nrivard/Sixty-n8k/Sixty-n8k/Sixty-n8k.pdf

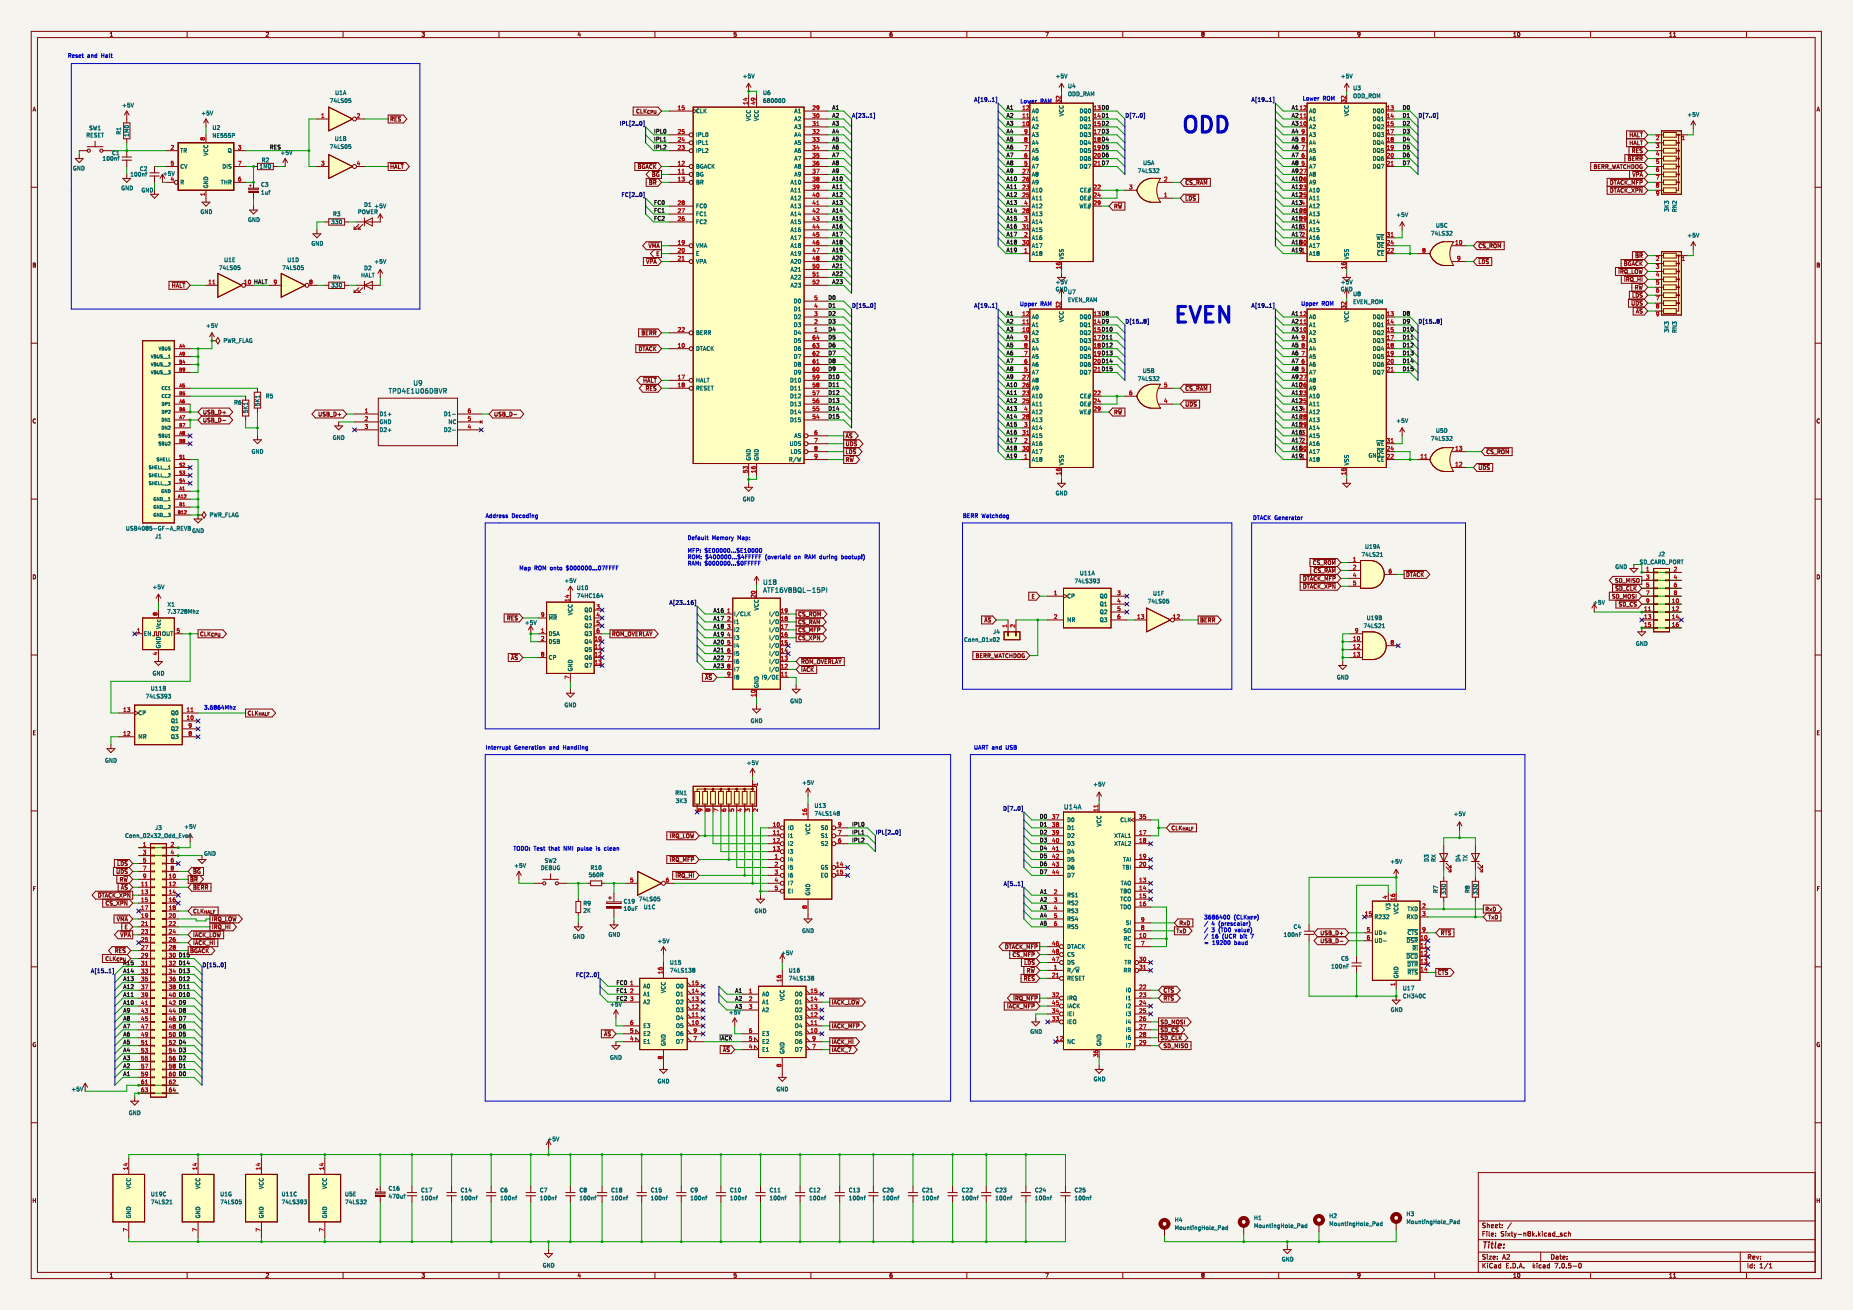
[picture p1: page 1]
