nrivard/Sixty-n8k/(list of files, drawings)

Other design files:
Sixty-n8k/freerouting.dsn
Sixty-n8k/Sixty-n8k.dsn
Sixty-n8k/temp-freerouting.dsn
