nrivard/Sixty-n8k/Sixty-n8k/Sixty-n8k.kicad_pcb

## KiCad design Sixty-n8k/Sixty-n8k.kicad_pcb (2024-03-06)

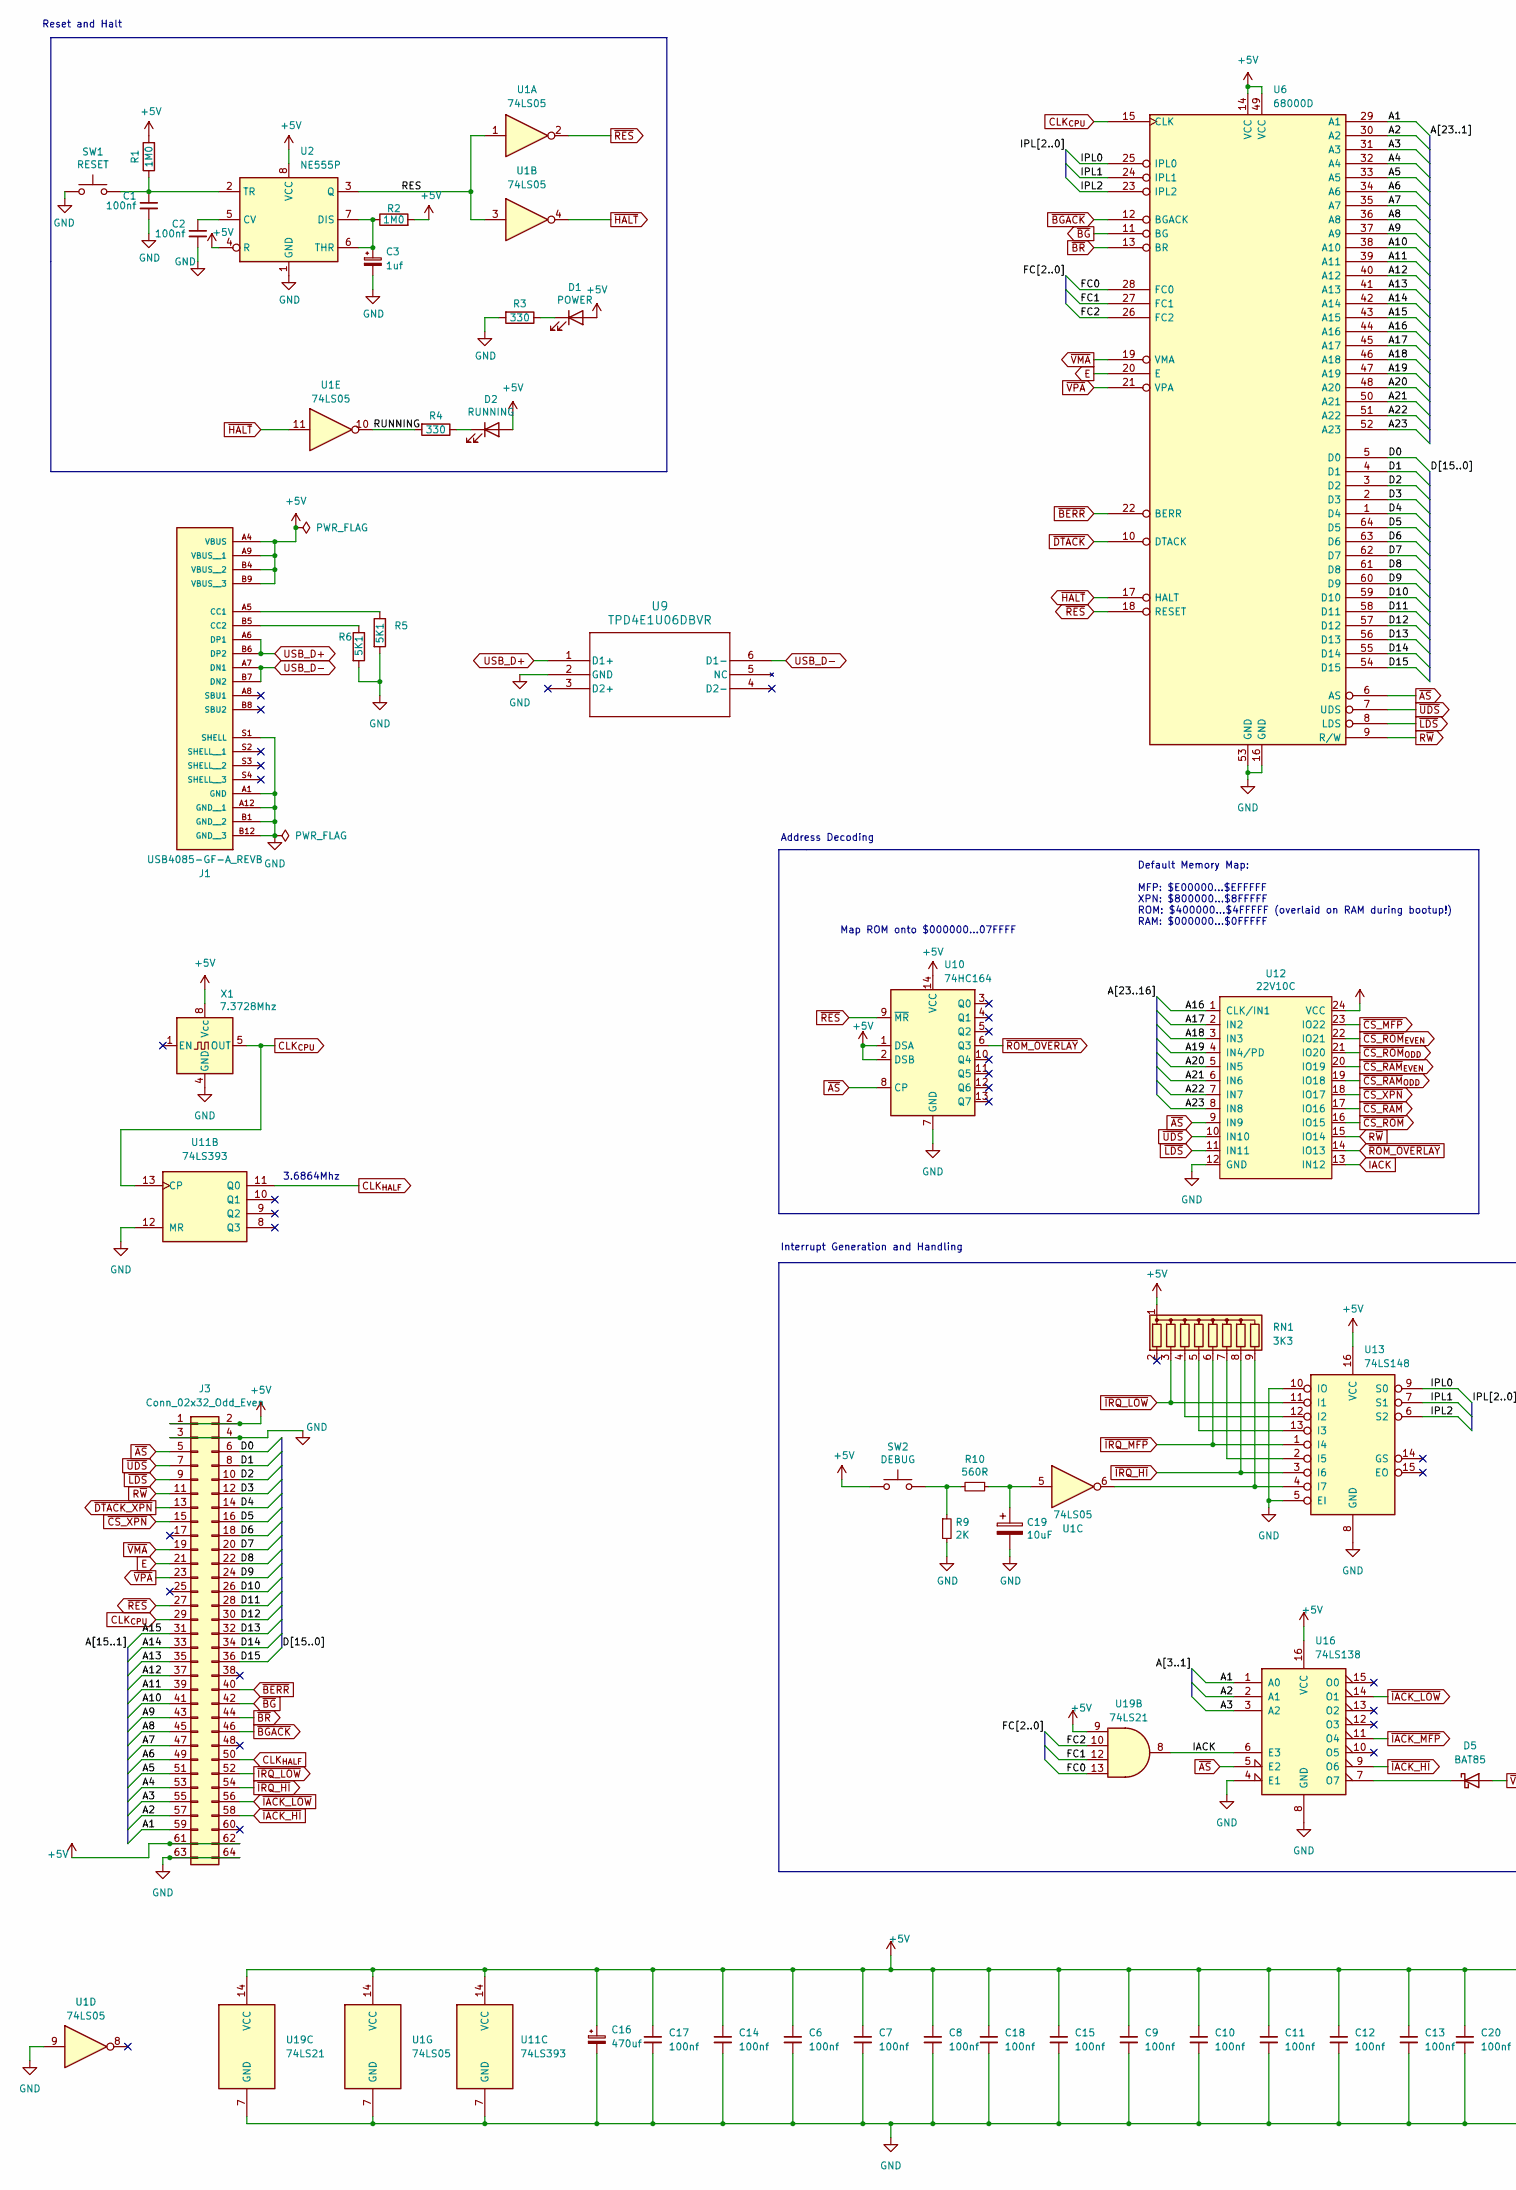
[picture p2: schematic Sixty-n8k.kicad_sch, part in row 1, column 1]

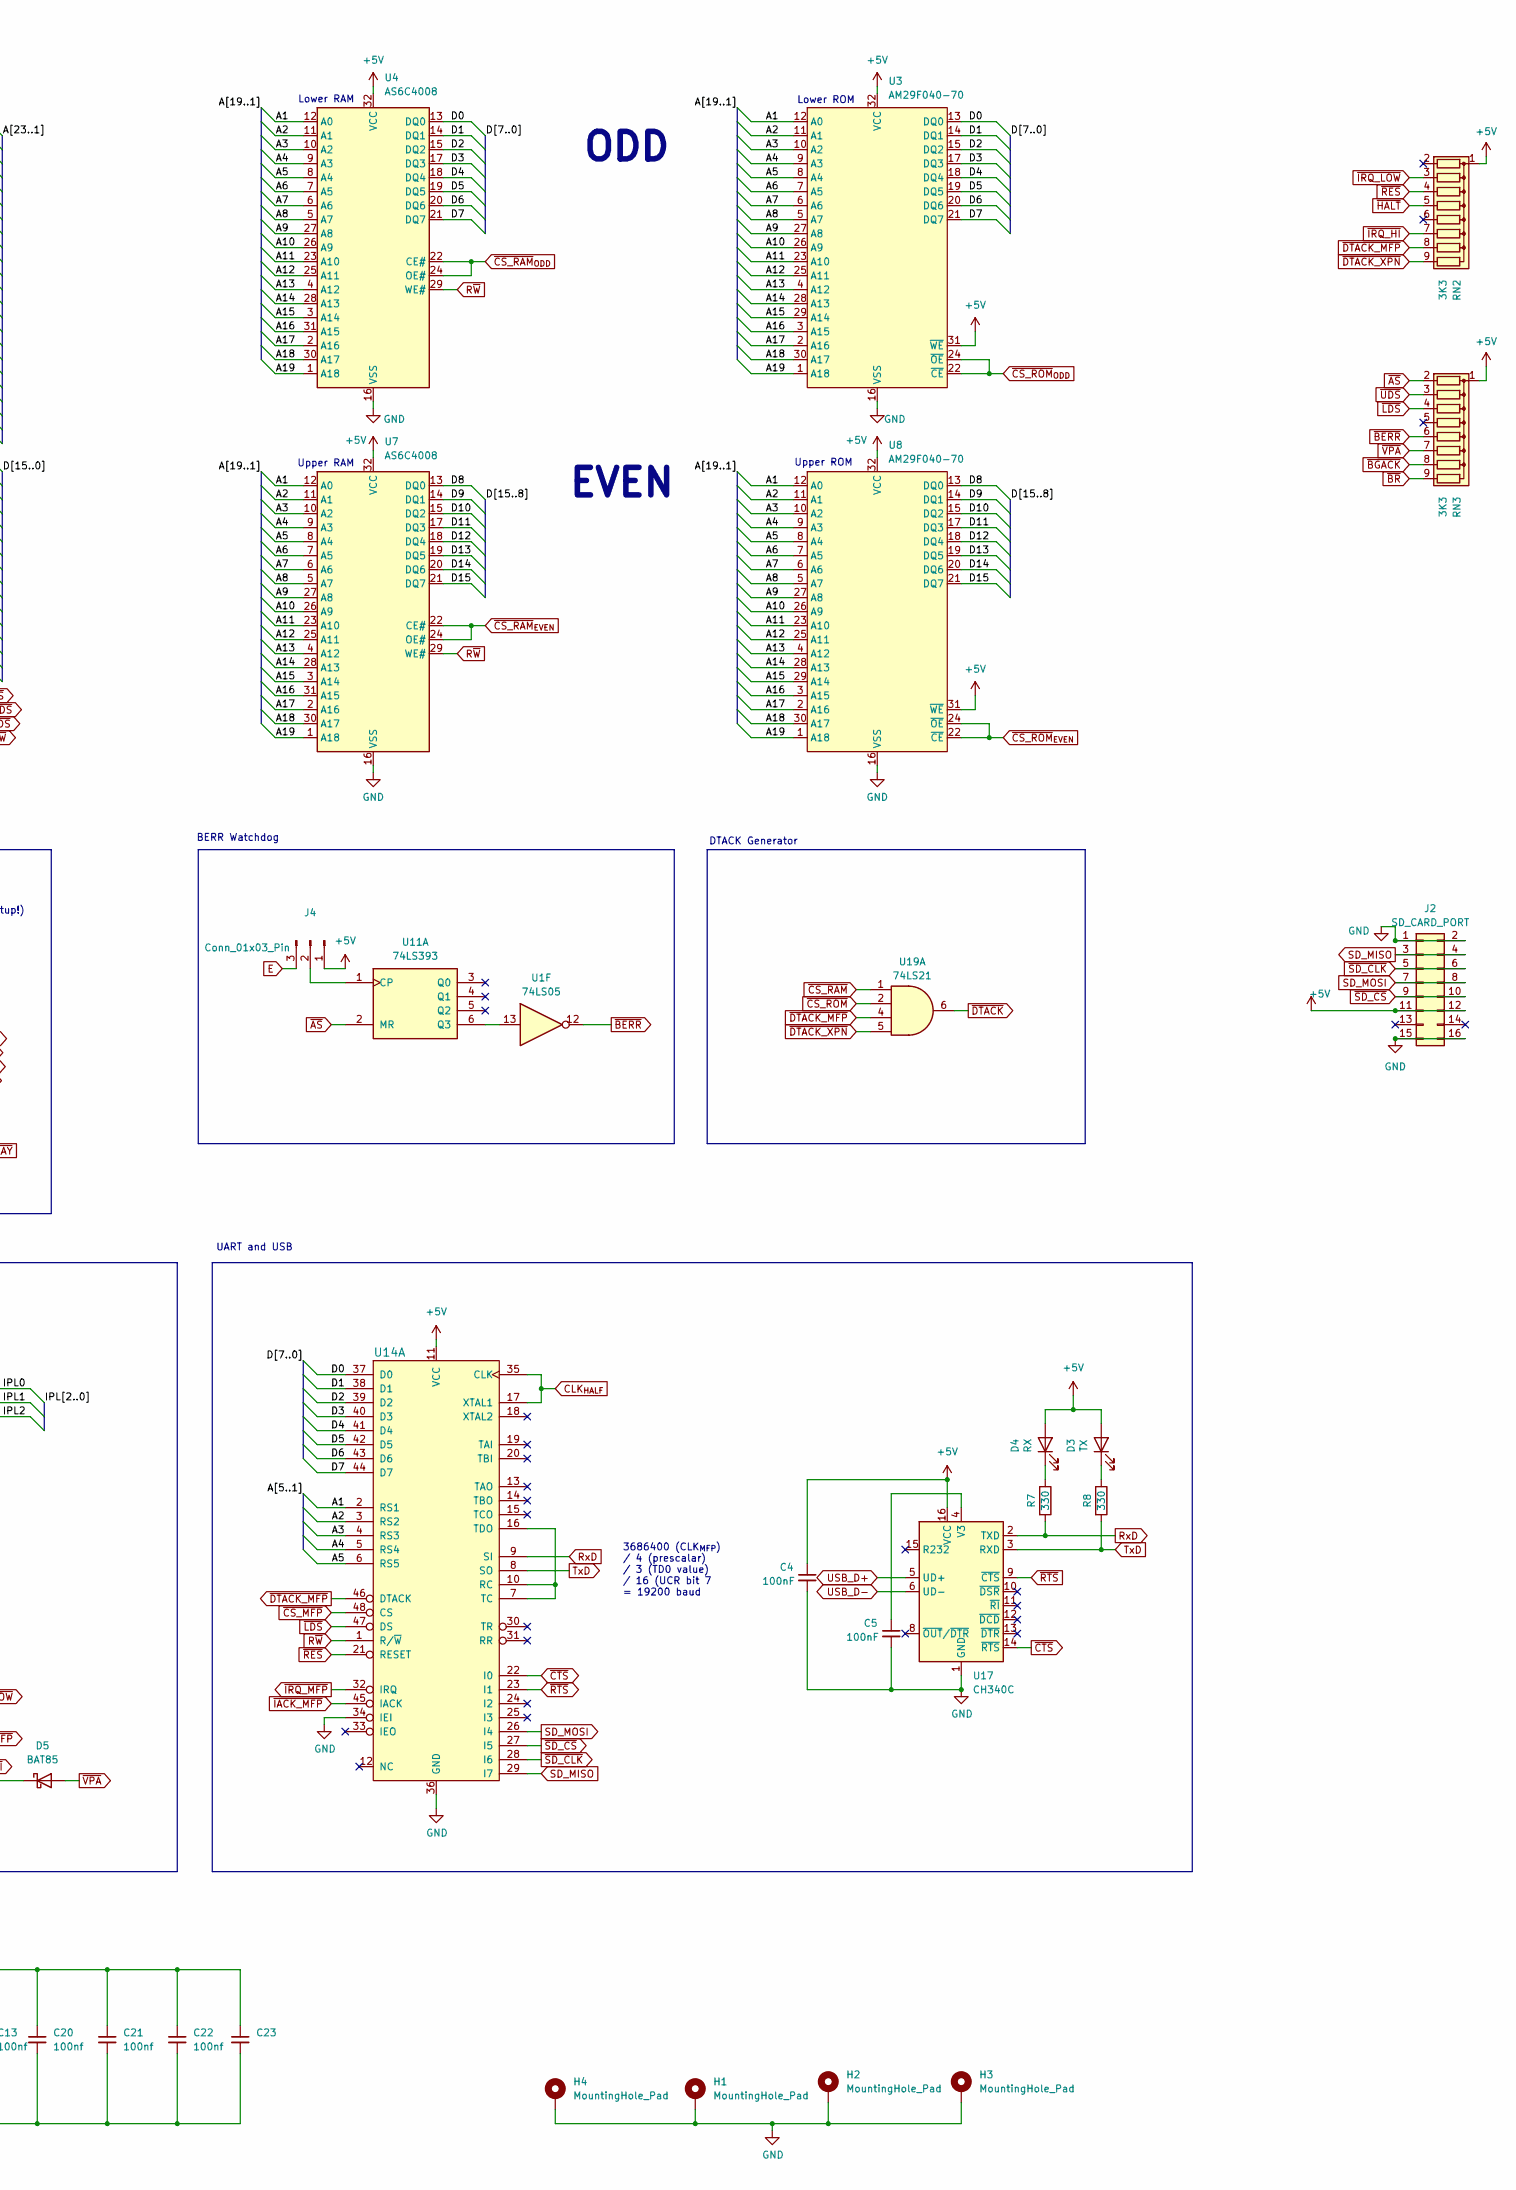
[picture p3: schematic Sixty-n8k.kicad_sch, part in row 1, column 2]

Parts:
C1, C2, C6, C7, C8, C9, C10, C11, C12, C13, C14, C15, C17, C18, C20, C21, C22, C23: 100nf; C_Disc_D5.0mm_W2.5mm_P2.50mm
C3: 1uf; CP_Radial_D4.0mm_P2.00mm
C4, C5: 100nF; C_Disc_D5.0mm_W2.5mm_P2.50mm
C16: 470uf; CP_Radial_D8.0mm_P3.80mm
C19: 10uF; CP_Radial_D4.0mm_P2.00mm
D1: POWER; LED_D3.0mm
D2: RUNNING; LED_D3.0mm
D3: TX; LED_D3.0mm
D4: RX; LED_D3.0mm
D5: BAT85; D_DO-41_SOD81_P7.62mm_Horizontal
H1, H2, H3, H4: MountingHole_Pad; MountingHole_3.2mm_M3_DIN965_Pad
J1: USB4085-GF-A_REVB; GCT_USB4085-GF-A_REVB; PARTREV B
J2: SD_CARD_PORT; PinSocket_2x08_P2.54mm_Vertical
J3: Conn_02x32_Odd_Even; PinSocket_2x32_P2.54mm_Vertical
J4: Conn_01x03_Pin; PinHeader_1x03_P2.54mm_Vertical
R1, R2: 1M0; R_Axial_DIN0207_L6.3mm_D2.5mm_P7.62mm_Horizontal
R3, R4, R7, R8: 330; R_Axial_DIN0207_L6.3mm_D2.5mm_P7.62mm_Horizontal
R5, R6: 5K1; R_Axial_DIN0207_L6.3mm_D2.5mm_P7.62mm_Horizontal
R9: 2K; R_Axial_DIN0207_L6.3mm_D2.5mm_P7.62mm_Horizontal
R10: 560R; R_Axial_DIN0207_L6.3mm_D2.5mm_P7.62mm_Horizontal
RN1, RN2, RN3: 3K3; R_Array_SIP9
SW1: RESET; SW_PUSH-12mm
SW2: DEBUG; SW_PUSH-12mm
U1: 74LS05; DIP-14_W7.62mm_Socket
U2: NE555P; DIP-8_W7.62mm
U3, U8: AM29F040-70; PLCC-32_THT-Socket
U4, U7: AS6C4008; DIP-32_W15.24mm_Socket
U6: 68000D; DIP-64_W22.86mm_Socket
U9: TPD4E1U06DBVR; SOT-23-6_Handsoldering
U10: 74HC164; DIP-14_W7.62mm_Socket
U11: 74LS393; DIP-14_W7.62mm_Socket
U12: 22V10C; DIP-24_W7.62mm_Socket
U13: 74LS148; DIP-16_W7.62mm_Socket
U14: MC68901P; DIP-48_W15.24mm_Socket
U16: 74LS138; DIP-16_W7.62mm_Socket
U17: CH340C; SOIC-16_3.9x9.9mm_P1.27mm
U19: 74LS21; DIP-14_W7.62mm_Socket
X1: 7.3728Mhz; Oscillator_DIP-8

Connections:
+5V: C4.1, C6.1, C7.1, C8.1, C9.1, C10.1, C11.1, C12.1, C13.1, C14.1, C15.1, C16.1, C17.1, C18.1, C20.1, C21.1, C22.1, C23.1, D1.2 (A), D2.2 (A), D3.2 (A), D4.2 (A), J1.A4 (VBUS), J1.A9 (VBUS__1), J1.B4 (VBUS__2), J1.B9 (VBUS__3), J2.11, J2.12, J3.1, J3.2, J3.61, J3.62, J4.1, R1.2, R2.2, RN1.1 (common), RN2.1 (common), RN3.1 (common), SW2.1, U1.14 (VCC), U2.4 (R), U2.8 (VCC), U3.31 (~WE), U3.32 (VCC), U4.32 (VCC), U6.14 (VCC), U6.49 (VCC), U7.32 (VCC), U8.31 (~WE), U8.32 (VCC), U10.1 (DSA), U10.2 (DSB), U10.14 (VCC), U11.14 (VCC), U12.24 (VCC), U13.16 (VCC), U14.11 (VCC), U16.16 (VCC), U17.16 (VCC), U19.9, U19.14 (VCC), X1.8 (Vcc)
/A1: J3.59, U3.12 (A0), U4.12 (A0), U6.29 (A1), U7.12 (A0), U8.12 (A0), U14.2 (RS1), U16.1 (A0)
/A2: J3.57, U3.11 (A1), U4.11 (A1), U6.30 (A2), U7.11 (A1), U8.11 (A1), U14.3 (RS2), U16.2 (A1)
/A3: J3.55, U3.10 (A2), U4.10 (A2), U6.31 (A3), U7.10 (A2), U8.10 (A2), U14.4 (RS3), U16.3 (A2)
/A4: J3.53, U3.9 (A3), U4.9 (A3), U6.32 (A4), U7.9 (A3), U8.9 (A3), U14.5 (RS4)
/A5: J3.51, U3.8 (A4), U4.8 (A4), U6.33 (A5), U7.8 (A4), U8.8 (A4), U14.6 (RS5)
/A6: J3.49, U3.7 (A5), U4.7 (A5), U6.34 (A6), U7.7 (A5), U8.7 (A5)
/A7: J3.47, U3.6 (A6), U4.6 (A6), U6.35 (A7), U7.6 (A6), U8.6 (A6)
/A8: J3.45, U3.5 (A7), U4.5 (A7), U6.36 (A8), U7.5 (A7), U8.5 (A7)
/A9: J3.43, U3.27 (A8), U4.27 (A8), U6.37 (A9), U7.27 (A8), U8.27 (A8)
/A10: J3.41, U3.26 (A9), U4.26 (A9), U6.38 (A10), U7.26 (A9), U8.26 (A9)
/A11: J3.39, U3.23 (A10), U4.23 (A10), U6.39 (A11), U7.23 (A10), U8.23 (A10)
/A12: J3.37, U3.25 (A11), U4.25 (A11), U6.40 (A12), U7.25 (A11), U8.25 (A11)
/A13: J3.35, U3.4 (A12), U4.4 (A12), U6.41 (A13), U7.4 (A12), U8.4 (A12)
/A14: J3.33, U3.28 (A13), U4.28 (A13), U6.42 (A14), U7.28 (A13), U8.28 (A13)
/A15: J3.31, U3.29 (A14), U4.3 (A14), U6.43 (A15), U7.3 (A14), U8.29 (A14)
/A16: U3.3 (A15), U4.31 (A15), U6.44 (A16), U7.31 (A15), U8.3 (A15), U12.1 (CLK/IN1)
/A17: U3.2 (A16), U4.2 (A16), U6.45 (A17), U7.2 (A16), U8.2 (A16), U12.2 (IN2)
/A18: U3.30 (A17), U4.30 (A17), U6.46 (A18), U7.30 (A17), U8.30 (A17), U12.3 (IN3)
/A19: U3.1 (A18), U4.1 (A18), U6.47 (A19), U7.1 (A18), U8.1 (A18), U12.4 (IN4/PD)
/A20: U6.48 (A20), U12.5 (IN5)
/A21: U6.50 (A21), U12.6 (IN6)
/A22: U6.51 (A22), U12.7 (IN7)
/A23: U6.52 (A23), U12.8 (IN8)
/D0: J3.6, U3.13 (DQ0), U4.13 (DQ0), U6.5 (D0), U14.37 (D0)
/D1: J3.8, U3.14 (DQ1), U4.14 (DQ1), U6.4 (D1), U14.38 (D1)
/D2: J3.10, U3.15 (DQ2), U4.15 (DQ2), U6.3 (D2), U14.39 (D2)
/D3: J3.12, U3.17 (DQ3), U4.17 (DQ3), U6.2 (D3), U14.40 (D3)
/D4: J3.14, U3.18 (DQ4), U4.18 (DQ4), U6.1 (D4), U14.41 (D4)
/D5: J3.16, U3.19 (DQ5), U4.19 (DQ5), U6.64 (D5), U14.42 (D5)
/D6: J3.18, U3.20 (DQ6), U4.20 (DQ6), U6.63 (D6), U14.43 (D6)
/D7: J3.20, U3.21 (DQ7), U4.21 (DQ7), U6.62 (D7), U14.44 (D7)
/D8: J3.22, U6.61 (D8), U7.13 (DQ0), U8.13 (DQ0)
/D9: J3.24, U6.60 (D9), U7.14 (DQ1), U8.14 (DQ1)
/D10: J3.26, U6.59 (D10), U7.15 (DQ2), U8.15 (DQ2)
/D11: J3.28, U6.58 (D11), U7.17 (DQ3), U8.17 (DQ3)
/D12: J3.30, U6.57 (D12), U7.18 (DQ4), U8.18 (DQ4)
/D13: J3.32, U6.56 (D13), U7.19 (DQ5), U8.19 (DQ5)
/D14: J3.34, U6.55 (D14), U7.20 (DQ6), U8.20 (DQ6)
/D15: J3.36, U6.54 (D15), U7.21 (DQ7), U8.21 (DQ7)
/FC0: U6.28 (FC0), U19.13
/FC1: U6.27 (FC1), U19.12
/FC2: U6.26 (FC2), U19.10
/IPL0: U6.25 (IPL0), U13.9 (S0)
/IPL1: U6.24 (IPL1), U13.7 (S1)
/IPL2: U6.23 (IPL2), U13.6 (S2)
/RES: U1.1, U1.3, U2.3 (Q)
/RUNNING: R4.2, U1.10
CLK_{CPU}: J3.29, U6.15 (CLK), U11.13 (CP), X1.5 (OUT)
CLK_{HALF}: J3.50, U11.11 (Q0), U14.17 (XTAL1), U14.35 (CLK)
E: J3.21, J4.3, U6.20 (E)
GND: C1.2, C2.2, C3.2, C4.2, C5.2, C6.2, C7.2, C8.2, C9.2, C10.2, C11.2, C12.2, C13.2, C14.2, C15.2, C16.2, C17.2, C18.2, C19.2, C20.2, C21.2, C22.2, C23.2, H1.1, H2.1, H3.1, H4.1, J1.A1 (GND), J1.A12 (GND__1), J1.B1 (GND__2), J1.B12 (GND__3), J1.S1 (SHELL), J2.1, J2.2, J2.15, J2.16, J3.3, J3.4, J3.63, J3.64, R3.2, R5.2, R6.2, R9.2, SW1.1, U1.7 (GND), U1.9, U2.1 (GND), U3.16 (VSS), U4.16 (VSS), U6.16 (GND), U6.53 (GND), U7.16 (VSS), U8.16 (VSS), U9.2 (GND), U10.7 (GND), U11.7 (GND), U11.12 (MR), U12.12 (GND), U13.5 (EI), U13.8 (GND), U13.10 (IO), U14.34 (IEI), U14.36 (GND), U16.4 (E1), U16.8 (GND), U17.1 (GND), U19.7 (GND), X1.4 (GND)
IACK: U12.13 (IN12), U16.6 (E3), U19.8
unnamed: C19.1, R10.1, U1.5
unnamed: D1.1 (K), R3.1
unnamed: D2.1 (K), R4.1
unnamed: D3.1 (K), R8.1
unnamed: D4.1 (K), R7.1
unnamed: D5.1 (K), U16.7 (O7)
unnamed: J1.A5 (CC1), R5.1
unnamed: J1.B5 (CC2), R6.1
unnamed: J4.2, U11.1 (CP)
unnamed: R9.1, R10.2, SW2.2
unnamed: RN1.4 (R3), U13.12 (I2)
unnamed: RN1.5 (R4), U13.13 (I3)
unnamed: RN1.7 (R6), U13.2 (I5)
unnamed: RN1.9 (R8), U1.6, U13.4 (I7)
unnamed: C2.1, U2.5 (CV)
unnamed: C3.1, R2.1, U2.6 (THR), U2.7 (DIS)
unnamed: C1.1, R1.1, SW1.2, U2.2 (TR)
unnamed: U1.13, U11.6 (Q3)
unnamed: U14.7 (TC), U14.10 (RC), U14.16 (TDO)
unnamed: C5.1, U17.4 (V3)
RxD: R7.2, U14.9 (SI), U17.2 (TXD)
R~W: J3.11, U4.29 (WE#), U6.9 (R/W), U7.29 (WE#), U12.15 (IO14), U14.1 (R/~W)
SD_MISO: J2.3, J2.4, U14.29 (I7)
SD_MOSI: J2.7, J2.8, U14.26 (I4)
TxD: R8.2, U14.8 (SO), U17.3 (RXD)
USB_D+: J1.A6 (DP1), J1.B6 (DP2), U9.1 (D1+), U17.5 (UD+)
USB_D-: J1.A7 (DN1), J1.B7 (DN2), U9.6 (D1-), U17.6 (UD-)
~AS: J3.5, RN3.2 (R1), U6.6 (AS), U10.8 (CP), U11.2 (MR), U12.9 (IN9), U16.5 (E2)
~BERR: J3.40, RN3.6 (R5), U1.12, U6.22 (BERR)
~BGACK: J3.46, RN3.8 (R7), U6.12 (BGACK)
~BG: J3.42, U6.11 (BG)
~BR: J3.44, RN3.9 (R8), U6.13 (BR)
~CS_MFP: U12.23 (IO22), U14.48 (CS)
~CS_RAM: U12.17 (IO16), U19.1
~CS_RAM_{EVEN}: U7.22 (CE#), U7.24 (OE#), U12.20 (IO19)
~CS_RAM_{ODD}: U4.22 (CE#), U4.24 (OE#), U12.19 (IO18)
~CS_ROM: U12.16 (IO15), U19.2
~CS_ROM_{EVEN}: U8.22 (~CE), U8.24 (~OE), U12.22 (IO21)
~CS_ROM_{ODD}: U3.22 (~CE), U3.24 (~OE), U12.21 (IO20)
~CS_XPN: J3.15, U12.18 (IO17)
~CTS: U14.22 (I0), U17.14 (~RTS)
~DTACK_MFP: RN2.8 (R7), U14.46 (DTACK), U19.4
~DTACK_XPN: J3.13, RN2.9 (R8), U19.5
~DTACK: U6.10 (DTACK), U19.6
~HALT: RN2.5 (R4), U1.4, U1.11, U6.17 (HALT)
~IACK_HI: J3.58, U16.9 (O6)
~IACK_LOW: J3.56, U16.14 (O1)
~IACK_MFP: U14.45 (IACK), U16.11 (O4)
~IRQ_HI: J3.54, RN1.8 (R7), RN2.7 (R6), U13.3 (I6)
~IRQ_LOW: J3.52, RN1.3 (R2), RN2.3 (R2), U13.11 (I1)
~IRQ_MFP: RN1.6 (R5), U13.1 (I4), U14.32 (IRQ)
~LDS: J3.9, RN3.4 (R3), U6.8 (LDS), U12.11 (IN11), U14.47 (DS)
~RES: J3.27, RN2.4 (R3), U1.2, U6.18 (RESET), U10.9 (~MR), U14.21 (RESET)
~ROM_OVERLAY: U10.6 (Q3), U12.14 (IO13)
~RTS: U14.23 (I1), U17.9 (~CTS)
~SD_CLK: J2.5, J2.6, U14.28 (I6)
~SD_CS: J2.9, J2.10, U14.27 (I5)
~UDS: J3.7, RN3.3 (R2), U6.7 (UDS), U12.10 (IN10)
~VMA: J3.19, U6.19 (VMA)
~VPA: D5.2 (A), J3.23, RN3.7 (R6), U6.21 (VPA)

Notes on the sheet:
ODD
3686400 (CLK_{MFP}) / 4 (prescalar) / 3 (TD0 value) / 16 (UCR bit 7 = 19200 baud
Reset and Halt
DTACK Generator
EVEN
Map ROM onto $000000...07FFFF
3.6864Mhz
Default Memory Map: MFP: $E00000...$EFFFFF XPN: $800000...$8FFFFF ROM: $400000...$4FFFFF (overlaid on RAM during bootup!) RAM: $000000...$0FFFFF
Lower RAM
BERR Watchdog
Upper ROM
UART and USB
Upper RAM
Lower ROM
Interrupt Generation and Handling
Address Decoding

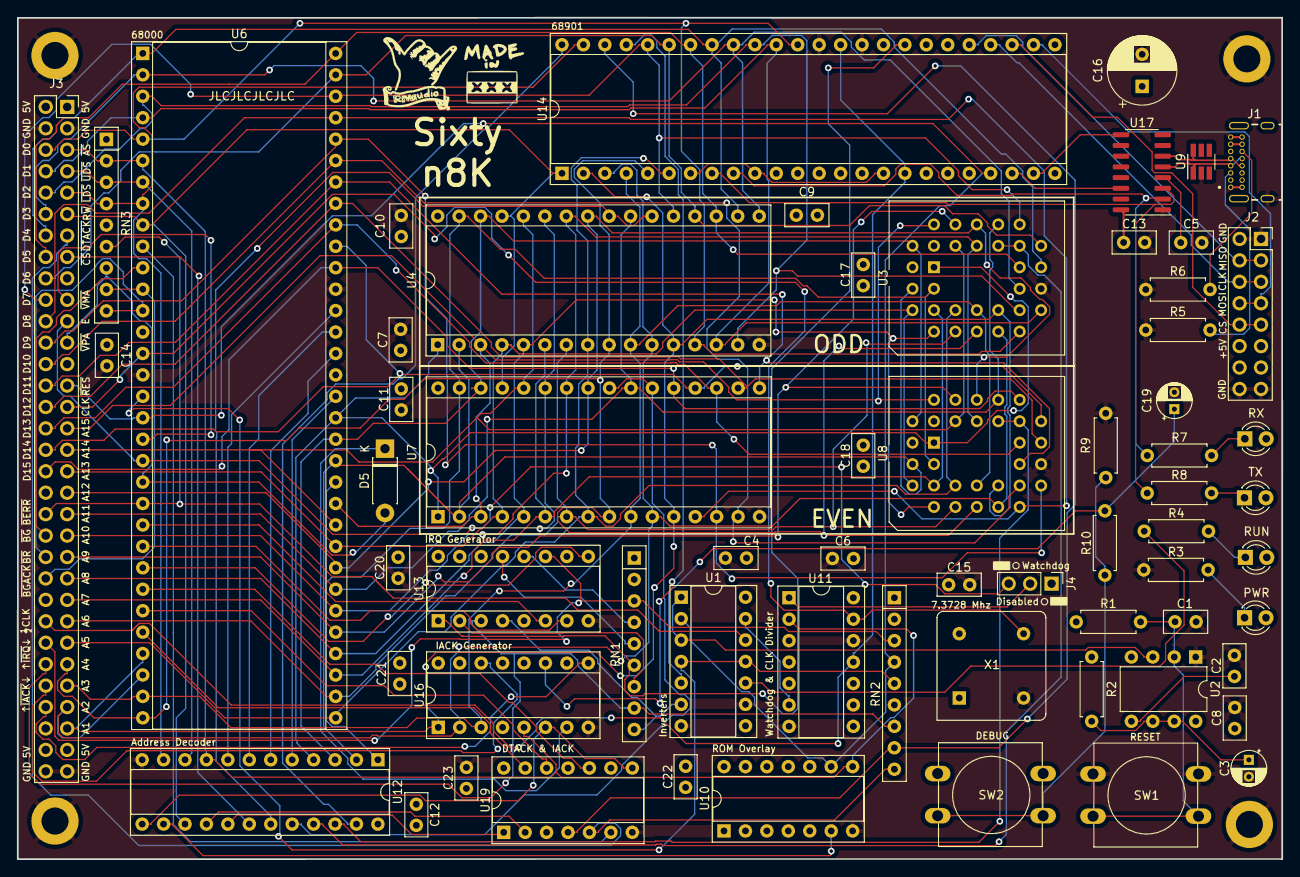
[picture p4: board Sixty-n8k.kicad_pcb from above]

Board: 4 copper layers, 149.9 x 99.7 mm, 70 parts (0 on the bottom side), 113 nets.

Other parts of the board:
G1: LOGO; Shaka
G2: LOGO; MadeInAMS
