nrivard/Sixty-n8k/(commit log)

2023-10-31 Start of schematic
    Uses 28L92 but I think for v1 i actually want to use 68901 MFP just like rosco 68k.
    [Sixty-n8k.kicad_pcb, Sixty-n8k.kicad_sch]
2023-11-29 Added MFP, IRQ handling, BERR watchdog, ROM overlay
    [Sixty-n8k.kicad_pcb, Sixty-n8k.kicad_sch]
2023-12-15 Schematic is complete (rc1)
    [Sixty-n8k.kicad_pcb]
2023-12-15 Starting to hand route. want to just layout and see what autorouter does though...
    [Sixty-n8k.kicad_pcb, Sixty-n8k.kicad_sch]
2023-12-18 new layout, start of hand routing but very complex
    [Sixty-n8k.dsn, Sixty-n8k.kicad_sch]
2023-12-19 Autoroute success (don't judge me)
    [Sixty-n8k.dsn, Sixty-n8k.kicad_sch, freerouting.dsn, temp-freerouting.dsn]
2023-12-20 About to remove 2nd 74HC138
    [Sixty-n8k.dsn, Sixty-n8k.kicad_sch]
2023-12-21 Simplified design, relaid out, re-routed
    [Sixty-n8k.dsn, Sixty-n8k.kicad_pcb, Sixty-n8k.kicad_sch]
2023-12-21 More sane layout and further reductions
    [Sixty-n8k.kicad_pcb, Sixty-n8k.kicad_sch]
2024-01-28 Adds GAL logic
    [Sixty-n8k.kicad_pcb, Sixty-n8k.kicad_sch]
2024-02-05 Formatting changes
    [Sixty-n8k.kicad_sch]
2024-02-07 Removed pullup on RWb
    [Sixty-n8k.kicad_pcb, Sixty-n8k.kicad_sch]
2024-02-09 Sent to pcb board house
    [Sixty-n8k-B_Cu.gbr, Sixty-n8k-B_Mask.gbr, Sixty-n8k-B_Paste.gbr, Sixty-n8k-B_Silkscreen.gbr, Sixty-n8k-Edge_Cuts.gbr, Sixty-n8k-F_Cu.gbr, Sixty-n8k-F_Mask.gbr, Sixty-n8k-F_Paste.gbr]
2024-02-10 Fixes a couple of small issues
    [Sixty-n8k.kicad_pcb, Sixty-n8k.kicad_sch]
2024-02-14 PCB cleanup
    [Sixty-n8k.kicad_pcb]
2024-02-23 footprint fix :(
    [Sixty-n8k.kicad_pcb, Sixty-n8k.kicad_sch]
2024-02-26 Fixed footprint issue
2024-03-01 Open collector via schottky diode for NMI
    [Sixty-n8k.kicad_pcb]
2024-03-01 Re-added logo
    [Sixty-n8k.kicad_pcb, Sixty-n8k.kicad_sch]
2024-03-06 Fixed short trace to CC resistor
    [Sixty-n8k.kicad_pcb, Sixty-n8k.kicad_sch]
